mrszb/sous_vide_cooker/Core/Inc/main.h

#define B1_Pin GPIO_PIN_13
#define B1_GPIO_Port GPIOC
#define B1_EXTI_IRQn EXTI15_10_IRQn
#define BTN_UP_Pin GPIO_PIN_0
#define BTN_UP_GPIO_Port GPIOC
#define BTN_DOWN_Pin GPIO_PIN_1
#define BTN_DOWN_GPIO_Port GPIOC
#define LCD_BACKLIGHT_Pin GPIO_PIN_0
#define LCD_BACKLIGHT_GPIO_Port GPIOA
#define USART_TX_Pin GPIO_PIN_2
#define USART_TX_GPIO_Port GPIOA
#define USART_RX_Pin GPIO_PIN_3
#define USART_RX_GPIO_Port GPIOA
#define LD2_Pin GPIO_PIN_5
#define LD2_GPIO_Port GPIOA
#define BTN_LEFT_Pin GPIO_PIN_4
#define BTN_LEFT_GPIO_Port GPIOC
#define BTN_RIGHT_Pin GPIO_PIN_5
#define BTN_RIGHT_GPIO_Port GPIOC
#define TEMP_DATA_Pin GPIO_PIN_2
#define TEMP_DATA_GPIO_Port GPIOB
#define LCD_RST_Pin GPIO_PIN_14
#define LCD_RST_GPIO_Port GPIOB
#define COOKER_Pin GPIO_PIN_8
#define COOKER_GPIO_Port GPIOC
#define TMS_Pin GPIO_PIN_13
#define TMS_GPIO_Port GPIOA
#define TCK_Pin GPIO_PIN_14
#define TCK_GPIO_Port GPIOA
#define LCD_SCLK_Pin GPIO_PIN_10
#define LCD_SCLK_GPIO_Port GPIOC
#define LCD_DC_Pin GPIO_PIN_11
#define LCD_DC_GPIO_Port GPIOC
#define LCD_DN_MOSI_Pin GPIO_PIN_12
#define LCD_DN_MOSI_GPIO_Port GPIOC
#define LCD_SCE_Pin GPIO_PIN_2
#define LCD_SCE_GPIO_Port GPIOD
#define SWO_Pin GPIO_PIN_3
#define SWO_GPIO_Port GPIOB
