mrszb/sous_vide_cooker/Core/Src/main.c

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
/* Includes ------------------------------------------------------------------*/
#include "main.h"

/* USER CODE BEGIN Includes */
#include "appmain.h"
#include <stdio.h>
#include <stdbool.h>
/* USER CODE END Includes */

SPI_HandleTypeDef hspi3;

TIM_HandleTypeDef htim2;
TIM_HandleTypeDef htim3;
TIM_HandleTypeDef htim10;
TIM_HandleTypeDef htim11;

UART_HandleTypeDef huart2;

void SystemClock_Config(void);
static void MX_GPIO_Init(void);
static void MX_USART2_UART_Init(void);
static void MX_TIM3_Init(void);
static void MX_SPI3_Init(void);
static void MX_TIM10_Init(void);
static void MX_TIM11_Init(void);
static void MX_TIM2_Init(void);
/* USER CODE BEGIN PFP */

void ReInit_PWM_CookerPin()
{
#define COMPLETE_INIT 0

#if COMPLETE_INIT
	MX_TIM3_Init();

#else
	  TIM_MasterConfigTypeDef sMasterConfig = {0};
	  TIM_OC_InitTypeDef sConfigOC = {0};

	  if (HAL_TIM_PWM_Init(&htim3) != HAL_OK)
	  {
	    Error_Handler();
	  }

	  sMasterConfig.MasterOutputTrigger = TIM_TRGO_RESET;
	  sMasterConfig.MasterSlaveMode = TIM_MASTERSLAVEMODE_DISABLE;
	  if (HAL_TIMEx_MasterConfigSynchronization(&htim3, &sMasterConfig) != HAL_OK)
	  {
	    Error_Handler();
	  }

	  sConfigOC.OCMode = TIM_OCMODE_PWM1;
	  sConfigOC.Pulse = 200 - 1;
	  sConfigOC.OCPolarity = TIM_OCPOLARITY_HIGH;
	  sConfigOC.OCFastMode = TIM_OCFAST_DISABLE;
	  if (HAL_TIM_PWM_ConfigChannel(&htim3, &sConfigOC, TIM_CHANNEL_3) != HAL_OK)
	  {
	    Error_Handler();
	  }

	  HAL_TIM_MspPostInit(&htim3);
#endif
}

/* USER CODE END PFP */

/* USER CODE BEGIN 0 */

const bool serial_console = true;

int _write(int file, char *ptr, int len)
{
	if (serial_console)
		HAL_UART_Transmit(&huart2, (uint8_t*)ptr, len, HAL_MAX_DELAY);
	return len;
}

// TODO
//int _read(int file, char *ptr, int len)

/* USER CODE END 0 */

/**
  * @brief  The application entry point.
  * @retval int
  */
int main(void)
{
  /* MCU Configuration--------------------------------------------------------*/

  /* Reset of all peripherals, Initializes the Flash interface and the Systick. */
  HAL_Init();

  /* Configure the system clock */
  SystemClock_Config();

  /* Initialize all configured peripherals */
  MX_GPIO_Init();
  MX_USART2_UART_Init();
  MX_TIM3_Init();
  MX_SPI3_Init();
  MX_TIM10_Init();
  MX_TIM11_Init();
  MX_TIM2_Init();
  /* USER CODE BEGIN 2 */
  appmain();
  /* USER CODE END 2 */

  /* Infinite loop */
  /* USER CODE BEGIN WHILE */
  while (1)
  {
    /* USER CODE END WHILE */

    /* USER CODE BEGIN 3 */
  }
  /* USER CODE END 3 */
}

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
