mrszb/sous_vide_cooker/(commit log)

2022-02-11 raw keypad scan, std out to uart
2022-02-12 debounced keypad scaned by timer interrupt generates key pressed/released events
2022-02-14 temp sensor functions
2022-02-14 use HAL_TIM_PeriodElapsedCallback instead user code in stm___xx_it.c interrupt code, fix autoreload on Timer 3
    [appmain.cpp, main.c, sous_vide_cooker.ioc]
2022-02-15 fixed temperature output for presentation
    [appmain.cpp]
2022-02-15 imported pid and sml library
2022-02-15 60 sec PID simulation/test
2022-02-15 use TIM11 as periodic interrupt, TIM3 now drives PWM
2022-02-16 blue button interrupt event added
2022-02-17 blinky can switch between pwm and output mode
2022-02-17 LCD backlight pin added
2022-02-17 asynchro temp measurement, basic pid control
2022-02-19 blinky SM broken out
    [appmain.cpp, blinky_actions.cpp, sm_blinky.hpp]
2022-02-20 state machine switches between screens
2022-02-20 update pid parameters
2022-02-20 PID library requires all parameters be positive
